adliechty/DaisySeedBreakout/BOM_Summary.csv

PCB Quantity | Mouser Component Cost | Mouser Missing Part Numbers | Digikey Component Cost | Digikey Missing Part Numbers | Cheapest Vendor Component Cost | Cheapest Vendor Missing Part Numbers
1 | 29.21 | 0 | 16.65 | 2 | 19.01 | 0
10 | 22.119999999999997 | 0 | 12.62 | 2 | 14.92 | 0
100 | 17.37 | 0 | 10.159999999999998 | 2 | 12.189999999999998 | 0
1000 | 12.69 | 0 | 8.909999999999998 | 2 | 10.34 | 0
