adliechty/DaisySeedBreakout/SymbolsAndFootprints/1x2Female/1x2Female.step

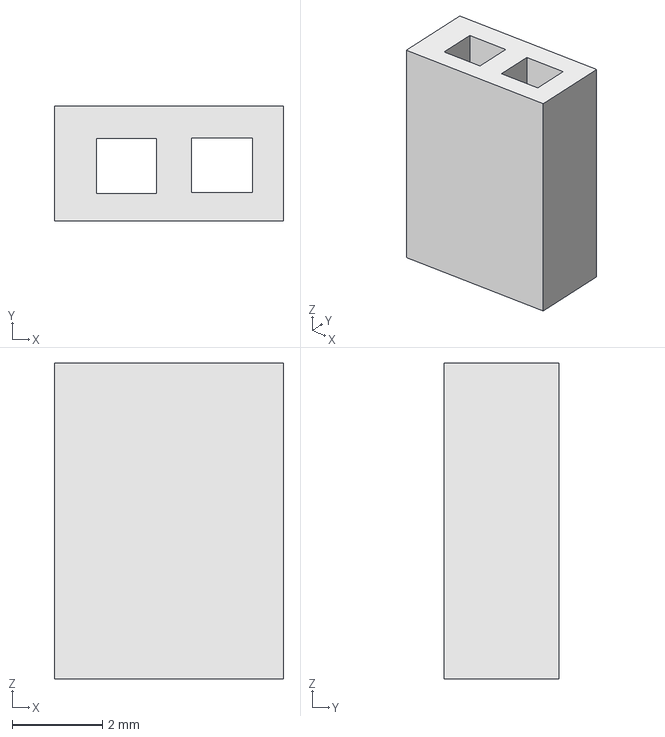
[picture p1: CAD file, 2023-09-30]
SymbolsAndFootprints/1x2Female/1x2Female.step
5.08 x 2.54 x 7.00 mm
