adliechty/DaisySeedBreakout/SymbolsAndFootprints/1x3Female/SSW-103-01-G-S.stp

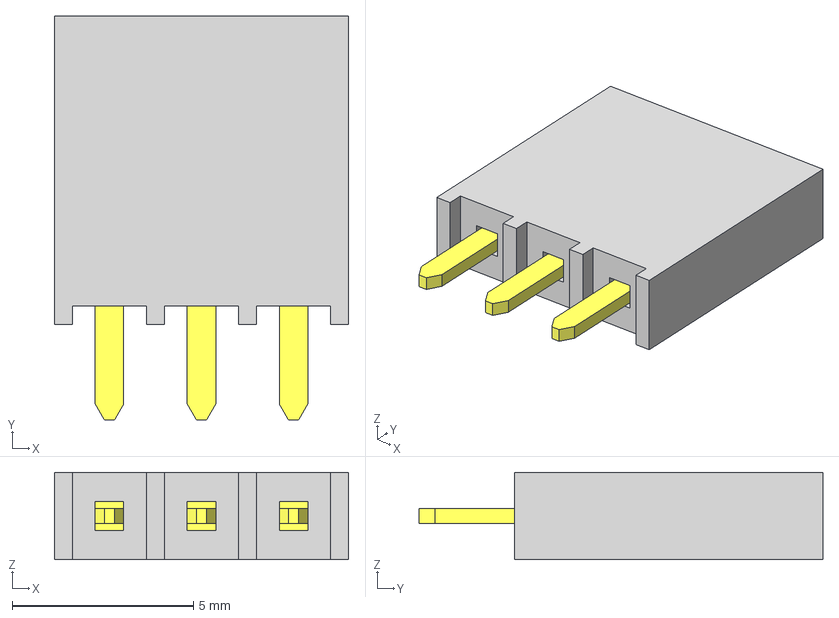
[picture p2: CAD file, 2023-09-27]
SymbolsAndFootprints/1x3Female/SSW-103-01-G-S.stp
8.13 x 11.2 x 2.41 mm
P2SSW-103-01-G-S
T1SSW-103-01-G-S
