adliechty/DaisySeedBreakout/SymbolsAndFootprints/1x6Female/1x6Female.step

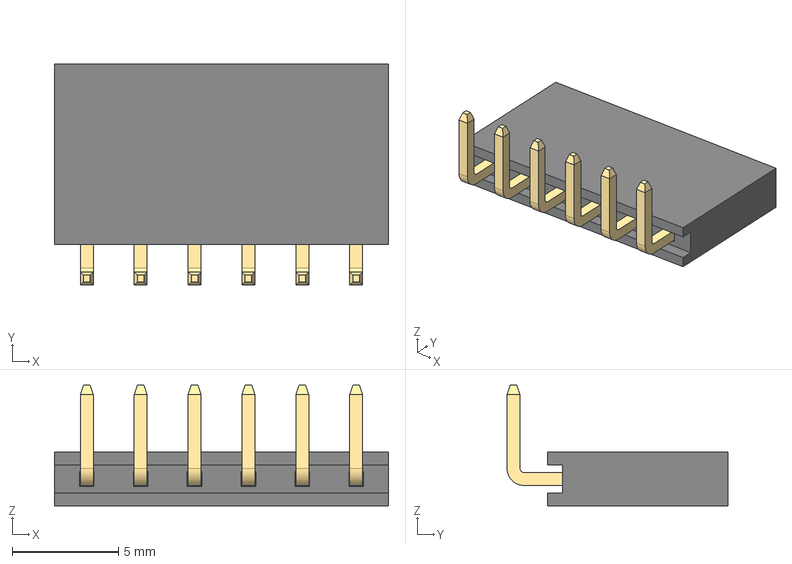
[picture p3: CAD file, 2023-09-27]
SymbolsAndFootprints/1x6Female/1x6Female.step
15.7 x 10.4 x 5.70 mm
