adliechty/DaisySeedBreakout/SymbolsAndFootprints/2x8Female/2x8Female.step

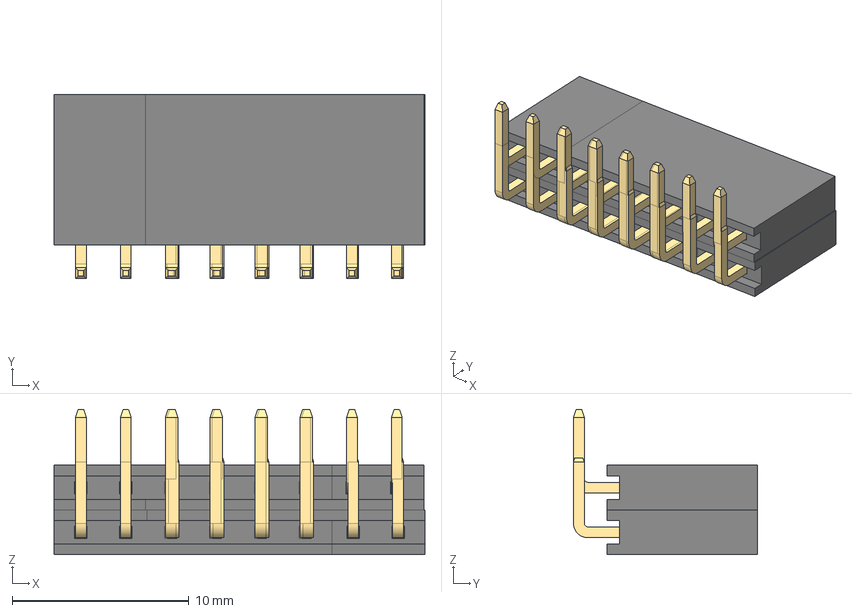
[picture p4: CAD file, 2023-09-27]
SymbolsAndFootprints/2x8Female/2x8Female.step
21.0 x 10.4 x 8.22 mm
1x6_RF
1x6_RF001
1x6_RF002
1x6_RF003
