adliechty/DaisySeedBreakout/SymbolsAndFootprints/Daisy Seed/DaisySeed-BodyPad003.step

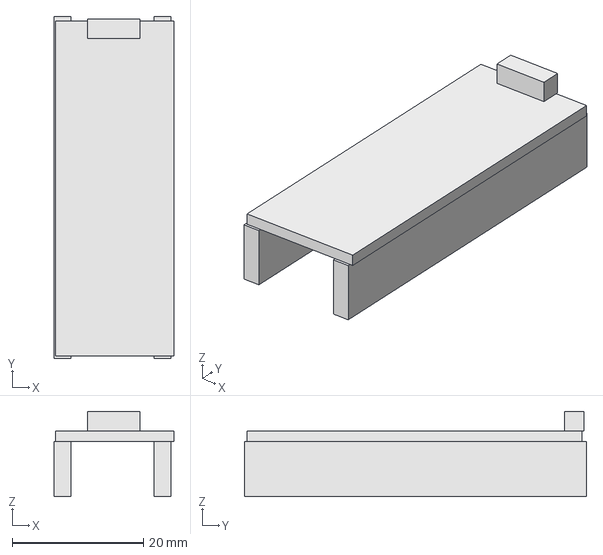
[picture p5: CAD file, 2023-09-25]
SymbolsAndFootprints/Daisy Seed/DaisySeed-BodyPad003.step
18.2 x 52.1 x 13.0 mm
