adliechty/DaisySeedBreakout/SymbolsAndFootprints/Microphone/Microphone.step

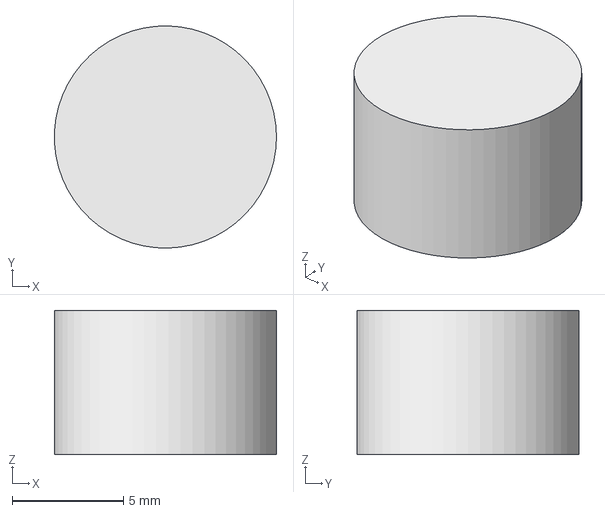
[picture p6: CAD file, 2023-09-25]
SymbolsAndFootprints/Microphone/Microphone.step
9.99 x 10.00 x 6.50 mm
