adliechty/DaisySeedBreakout/SymbolsAndFootprints/STX-4235-3-3-N/DaisySeed-BodyPad003.step

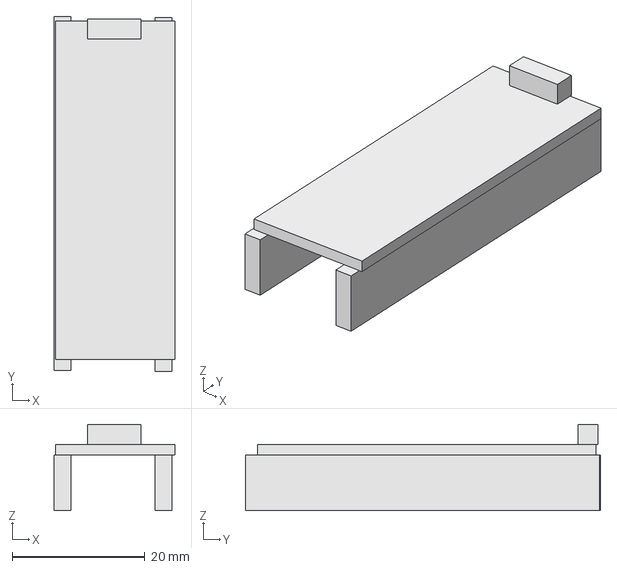
[picture p8: CAD file, 2023-09-25]
SymbolsAndFootprints/STX-4235-3-3-N/DaisySeed-BodyPad003.step
18.2 x 53.5 x 13.0 mm
