adliechty/DaisySeedBreakout/SymbolsAndFootprints/SurfaceMountAudio/surfaceMountAudio.step

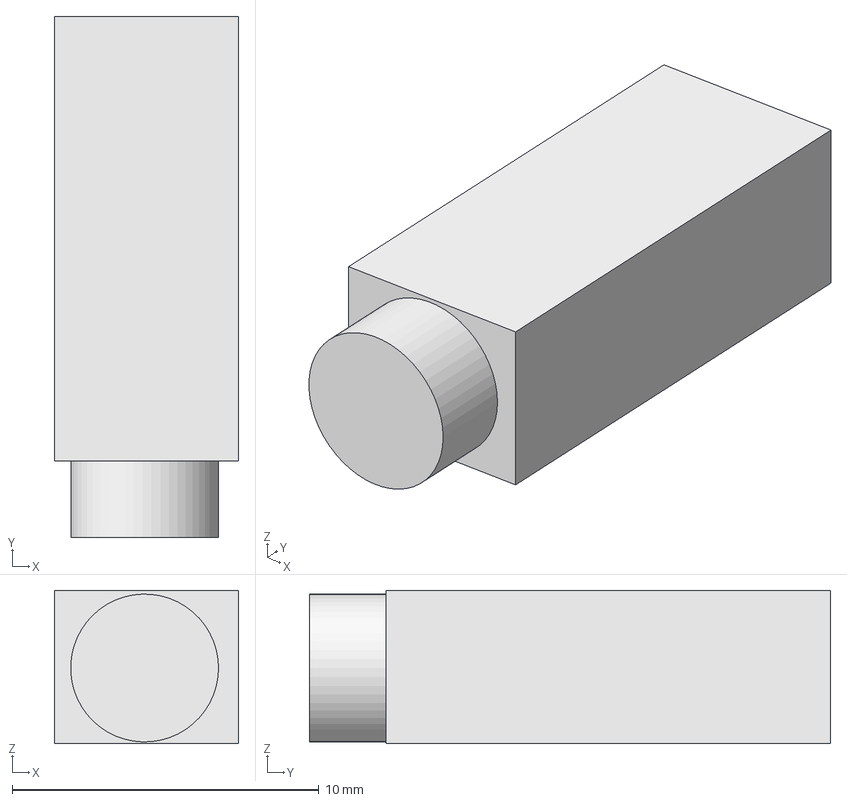
[picture p9: CAD file, 2023-09-26]
SymbolsAndFootprints/SurfaceMountAudio/surfaceMountAudio.step
6.00 x 17.0 x 5.00 mm
