adliechty/DaisySeedBreakout/SymbolsAndFootprints/STX-4235-3-3-N/Dual Audio-Body.step

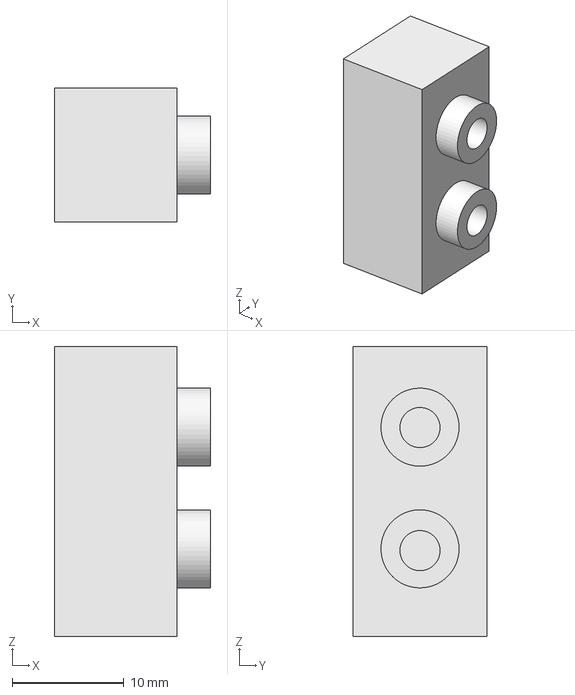
[picture p10: CAD file, 2023-09-25]
SymbolsAndFootprints/STX-4235-3-3-N/Dual Audio-Body.step
14.0 x 12.0 x 26.0 mm
