adliechty/DaisySeedBreakout/SymbolsAndFootprints/2x10FemaleHeader/87606-310LF.step

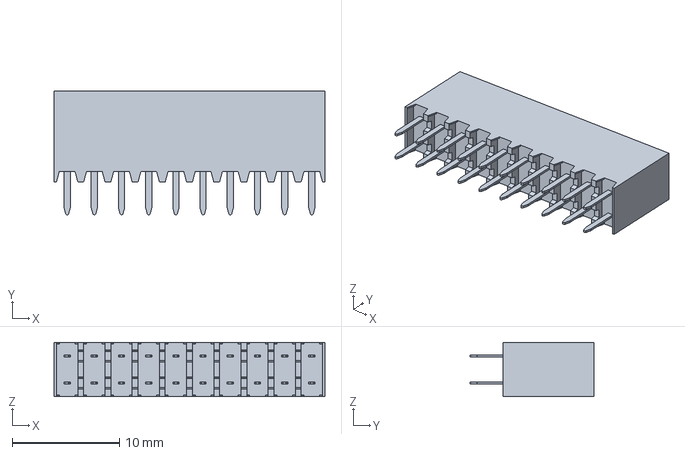
[picture p11: CAD file, 2023-10-08]
SymbolsAndFootprints/2x10FemaleHeader/87606-310LF.step
25.3 x 11.6 x 5.08 mm
