adliechty/DaisySeedBreakout/(list of files, cad)

Other CAD files:
SymbolsAndFootprints/Daisy Seed/DaisySeed-BodySketch003.step
SymbolsAndFootprints/Daisy Seed/DaisySeed.FCStd
SymbolsAndFootprints/STX-4235-3-3-N/Dual Audio.FCStd
SymbolsAndFootprints/Daisy Seed/Daisy Seed.f3d
SymbolsAndFootprints/Daisy Seed/Daisy Seed.iges
SymbolsAndFootprints/Daisy Seed/Daisy Seed.skp
SymbolsAndFootprints/Microphone/Microphone.FCStd
SymbolsAndFootprints/SurfaceMountAudio/surfaceMountAudio.FCStd
