adliechty/DaisySeedBreakout/DaisySeedBreakout.kicad_pcb

## KiCad design DaisySeedBreakout.kicad_pcb (2023-11-04)

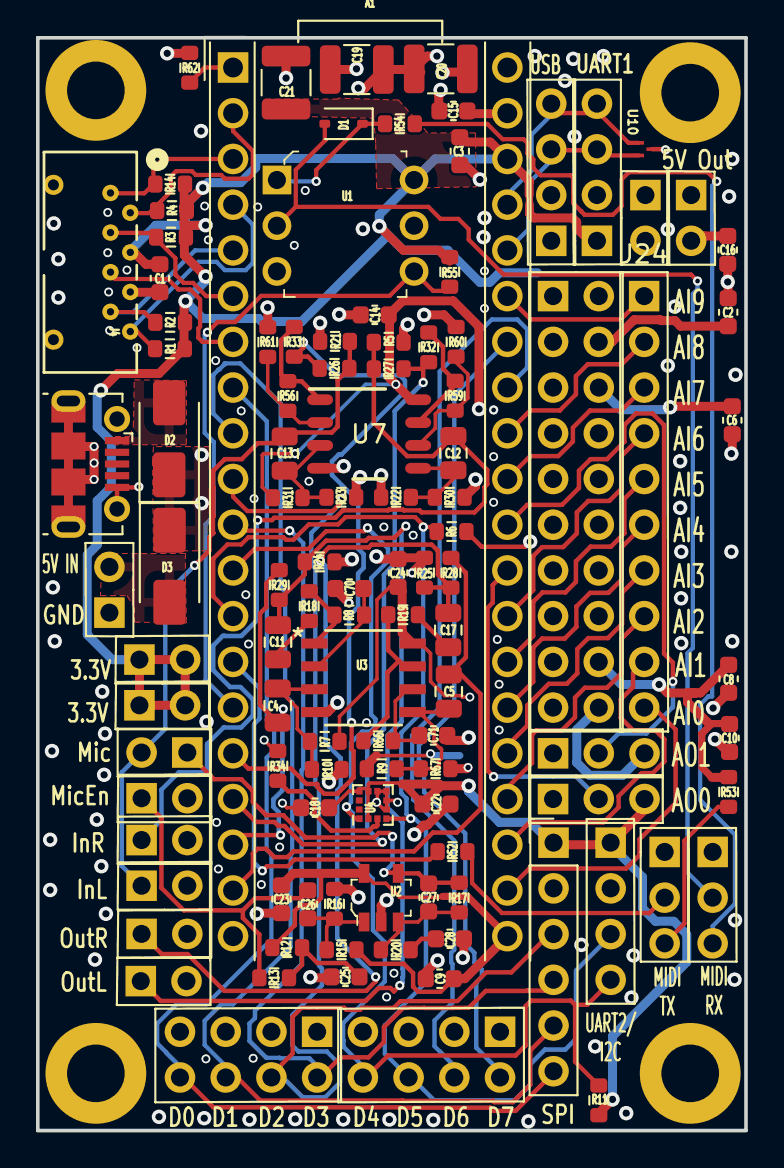
[picture p12: board DaisySeedBreakout.kicad_pcb from above]

Board: 4 copper layers, 39.3 x 60.7 mm, 113 parts (0 on the bottom side), 71 nets.

Parts:
A1: Electrosmith_Daisy_Seed_Rev4; Electrosmith_Daisy_Seed
C1, C2, C3, C6, C8, C9, C10, C14, C15, C16, C18, C22, C23, C24, C25, C26: 0.1uF 0402; C_0603_1608Metric
C4, C5, C11, C12, C13, C17: 10U; C_0805_2012Metric
C19: 100uF; C_1210_3225Metric
C20, C21: DNP_100uF; C_1210_3225Metric
C27: 100pF COG; C_0603_1608Metric
C28: 1uF; C_0603_1608Metric
C70, C71: DNP; C_0603_1608Metric
D1: D_Schottky; D_SOD-323
D2, D3: SS54; D_SMA
H1, H2, H3, H4: MountingHole; MountingHole_3.2mm_M3_DIN965_Pad
J1, J3, J10, J14: Conn_01x03; PinHeader_1x03_P2.54mm_Vertical_Female
J2, J6, J8, J9, J11, J12, J13, J16, J17, J25, J26: Conn_01x02; PinHeader_1x02_P2.54mm_VerticalFemale
J4: Micro_SD_Card; CONN_PJS008U-3000-0_YAM
J5, J7, J20: Conn_01x04; PinHeader_1x04_P2.54mm_Vertical_Female
J15: USB_B_Micro; USB_Micro-B_Molex-105017-0001
J18, J21: Conn_02x04; PinHeader_2x04_P2.54mm_Vertical_Female
J19: Conn_01x06; PinHeader_1x06_P2.54mm_Vertical_Female
J23: Pins_02x10_P2.54mm_TH; PinHeader_2x10_P2.54mm_Vertical
J24: Conn_01x10; PinHeader_1x10_P2.54mm_Vertical_Female
R1, R2, R3, R4, R14: 47k; R_0603_1608Metric
R5, R7, R9, R10, R15, R16, R21, R22, R23, R24, R25, R30, R31, R67: 1M; R_0603_1608Metric
R6, R11, R20: 10k; R_0603_1608Metric
R8, R56, R59, R62, R66: 0; R_0603_1608Metric
R12, R13: 2.2k; R_0603_1608Metric
R17: 100k; R_0603_1608Metric
R18, R19: 100; R_0603_1608Metric
R26, R27, R28, R29, R34, R60, R61: DNP; R_0603_1608Metric
R32, R33: 4.7k; R_0603_1608Metric
R52: 10; R_0603_1608Metric
R53: 33; R_0603_1608Metric
R54: 220; R_0603_1608Metric
R55: 470; R_0603_1608Metric
U1: H11L1M; DIP-6_W7.62mm
U2: MAX4466EXK_T; SOT-353
U3: D8_TEX
U4: LIS2DE12; LGA-12_2x2mm_P0.5mm
U7: TLV9062IDR; D0008A_N
U10: TPD2EUSB30ADRTR; DRT3

Connections:
+3.3V: A1.38 (3V3_D), C1.1, C2.1, C3.1, C6.1, C8.1, C10.1, C18.1, C21.1, C22.1, J4.4 (VDD), J7.1, J10.3, J14.3, J19.1, J20.1, J23.2, J23.4, J23.6, J23.8, J23.10, J23.12, J23.14, J23.16, J23.18, J23.20, J25.1, J25.2, J26.1, J26.2, R1.1, R2.1, R3.1, R4.1, R6.1, R11.1, R14.1, R53.1, R55.2, U1.6 (VCC), U4.2 (~CS), U4.9 (Vdd), U4.10 (Vdd_IO)
+3.3VA: A1.21 (3V3_A), C9.1, C14.1, C23.1, C24.1, R7.1, R9.1, R12.2, R15.2, R30.1, R31.1, U2.5 (VCC), U3.8 (V+), U7.8 (V+)
+5V: A1.39 (VIN), C15.1, C16.1, C19.1, C20.1, D2.1 (K), D3.1 (K), J5.1, J9.1, J9.2, J16.1, J16.2
/AI_0: A1.22 (ADC_0), J24.10
/AI_1: A1.23 (ADC_1), J24.9
/AI_2: A1.24 (ADC_2), J24.8
/AI_3: A1.25 (ADC_3), J24.7
/AI_4: A1.26 (ADC_4), J24.6
/AI_5: A1.27 (ADC_5), J24.5
/AI_6: A1.28 (ADC_6), J24.4
/AI_7: A1.31 (SAI2_MCLK), J24.3
/AI_8: A1.32 (SAI2_SD_B), J24.2
/AI_9: A1.35 (SAI2_SCK), J24.1
/AO_0: A1.29 (DAC_OUT2), J10.2
/AO_1: A1.30 (DAC_OUT1), J14.2
/Audio In/L_in+: C13.2, R23.1, R31.2, U7.3 (IN+)
/Audio In/L_in-: R56.2, R61.1, U7.2 (IN-)
/Audio In/L_out+: R33.2, R56.1, U7.1 (OUT)
/Audio In/R_in+: C12.2, R22.1, R30.2, U7.5 (IN+)
/Audio In/R_in-: R59.2, R60.1, U7.6 (IN-)
/Audio In/R_out+: R32.2, R59.1, U7.7 (OUT)
/Audio Out/L_in+: C4.2, R7.2, R10.1, U3.3 (+IN_A)
/Audio Out/L_in-: C70.1, R8.1, U3.2 (-A)
/Audio Out/L_out: R8.2, R18.1, U3.1
/Audio Out/R_in+: C5.2, R9.2, R67.1, U3.5 (+IN_B)
/Audio Out/R_in-: C71.1, R66.1, U3.6 (-B)
/Audio Out/R_out: R19.1, R66.2, U3.7
/Audio_IN_1: A1.16 (AUDIO_IN_1), R26.1, R33.1
/Audio_IN_2: A1.17 (AUDIO_IN_2), R27.1, R32.1
/Audio_IN_L_CONN: C13.1, J8.2, J12.1, R21.1, R26.2
/Audio_IN_R_CONN: C12.1, J13.1, R5.1, R27.2
/Audio_OUT_1: A1.18 (AUDIO_OUT_1), C4.1, R29.2
/Audio_OUT_2: A1.19 (AUDIO_OUT_2), C5.1, R28.2
/Audio_OUT_L_CONN: C11.2, J2.1, R24.1, R29.1
/Audio_OUT_R_CONN: C17.2, J11.1, R25.1, R28.1
/Condensor Microphone/MIC_BIAS: C25.1, R12.1, R13.2
/Condensor Microphone/MIC_CONN: C26.1, J17.1, R13.1
/Condensor Microphone/MIC_IN+: C26.2, R15.1, R16.2, U2.1
/Condensor Microphone/MIC_IN-: C27.1, R17.2, R20.2, U2.3
/DIO0_CS: A1.8 (SPI1_CS), J19.6, J21.8
/DIO1_SCK: A1.9 (SPI1_SCK), J19.5, J21.6
/DIO2_POCI: A1.10 (SPI1_POCI), J19.3, J21.4
/DIO3_PICO: A1.11 (SPI1_PICO), J19.4, J21.2
/DIO4_SCL_RX: A1.12 (I2C1_SCL), J7.4, J18.8, R11.2, U4.1 (SCL/SPC)
/DIO5_SDA_TX: A1.13 (I2C1_SDA), J7.3, J18.6, R6.2, U4.4 (SDA/SDI)
/DIO6: A1.33 (SAI2_SD_A), J18.4
/DIO7: A1.34 (SAI2_FS), J18.2
/HEADER_5V: D3.2 (A), J6.2
/MIDI_IN_CONN: D1.2 (A), J3.2, U1.2
/MIDI_IN_CONN_R: J3.3, R54.2
/MIDI_IN_Diode: D1.1 (K), R54.1, U1.1
/MIDI_TX_CONN: J1.2, R52.2
/MIDI_TX_PWR: J1.3, R53.2
/MIDI_UART_RX: A1.15 (USART1_RX), R55.1, U1.4 (VO)
/MIDI_UART_TX: A1.14 (USART1_TX), R52.1
/Mic_OUT: C27.2, J8.1, R17.1, U2.4
/SD_CLK: A1.7 (SD_CLK), J4.5 (CLK)
/SD_CMD: A1.6 (SD_CMD), J4.3 (CMD), R3.2
/SD_D0: A1.5 (SD_DATA_0), J4.7 (DAT0), R2.2
/SD_D1: A1.4 (SD_DATA_1), J4.8 (DAT1), R1.2
/SD_D2: A1.3 (SD_DATA_2), J4.1 (DAT2), R14.2
/SD_D3: A1.2 (SD_DATA_3), J4.2 (DAT3/CD), R4.2
/USB_5V: D2.2 (A), J15.1 (VBUS)
/USB_n: A1.36 (USB_D_-), J5.3, J20.3, U10.2 (D-)
/USB_p: A1.37 (USB_D_+), J5.4, J20.4, U10.1 (D+)
GND: A1.20 (AGND), A1.40 (DGND), C1.2, C2.2, C3.2, C6.2, C8.2, C9.2, C10.2, C14.2, C15.2, C16.2, C18.2, C19.2, C20.2, C21.2, C22.2, C23.2, C24.2, C25.2, C28.1, C70.2, C71.2, H1.1, H2.1, H3.1, H4.1, J1.1, J2.2, J3.1, J4.6 (VSS), J5.2, J6.1, J7.2, J10.1, J11.2, J12.2, J13.2, J14.1, J15.5 (GND), J15.6 (Shield), J17.2, J18.1, J18.3, J18.5, J18.7, J19.2, J20.2, J21.1, J21.3, J21.5, J21.7, J23.1, J23.3, J23.5, J23.7, J23.9, J23.11, J23.13, J23.15, J23.17, J23.19, R5.2, R10.2, R16.1, R21.2, R22.2, R23.2, R24.2, R25.2, R34.1, R60.2, R61.2, R62.2, R67.2, U1.5 (GND), U2.2 (GND), U3.4 (V-), U4.5 (RES), U4.6 (GND), U4.7 (GND), U4.8 (GND), U7.4 (V-), U10.3 (GND)
unnamed: A1.1 (USB_ID), R62.1
unnamed: C11.1, R18.2
unnamed: C17.1, R19.2
unnamed: C28.2, R20.1
unnamed: R34.2, U4.3 (SA0/SDO)
