adliechty/DaisySeedBreakout/(commit log)

2023-09-22 First addition
    [Audio Out.kicad_sch, AudioInSum.kicad_sch, Condensor Microphone.kicad_sch, DaisySeedBreakout.kicad_pcb, DaisySeedBreakout.kicad_sch, I2C 24 GPIO.kicad_sch, microSD.kicad_sch]
2023-09-23 Fixed ultralibrarian library with capital letter difference
    [Audio Out.kicad_sch, AudioInSum.kicad_sch, DaisySeedBreakout.kicad_pcb, DaisySeedBreakout.kicad_sch]
2023-09-23 added knob headers, MIDI in header
    [Audio Out.kicad_sch, DaisySeedBreakout.kicad_pcb, DaisySeedBreakout.kicad_sch]
2023-09-24 added double high audio jack
    [DaisySeedBreakout.kicad_pcb, DaisySeedBreakout.kicad_sch]
2023-09-25 adding 3d models
    [Daisy Seed.f3d, Daisy Seed.iges, Daisy Seed.skp, DaisySeed-BodyPad003.step, DaisySeed-BodySketch003.step, DaisySeed.FCStd, DaisySeedBreakout.kicad_pcb, DaisySeedBreakout.kicad_sch]
2023-09-26 adding mono connectors, CV, and gate as well
    [AudioInSum.kicad_sch, DaisySeedBreakout.kicad_pcb, DaisySeedBreakout.kicad_sch, Microphone.FCStd, surfaceMountAudio.FCStd, surfaceMountAudio.step]
2023-09-27 update design to use more headers. Need to figure out easy way to integrate connectors in modular but easy to use way without dangling wires
    [1x6Female.step, 2x8Female.step, DaisySeedBreakout.kicad_pcb, DaisySeedBreakout.kicad_sch, SSW-103-01-G-S.stp]
2023-09-28 added dual audio back in to prototype that concept
    [1x2Female.step, DaisySeedBreakout.kicad_pcb, DaisySeedBreakout.kicad_sch]
2023-09-30 Converted circuits to sub circuits. Removed MIDI connector, changed to header only
    [1x2Female.step, AI_GPIO.kicad_sch, Analog_out_conn.kicad_sch, DaisySeedBreakout.kicad_pcb, DaisySeedBreakout.kicad_sch, GPIO_Conn.kicad_sch, MIDI_IN.kicad_sch, MIDI_OUT.kicad_sch]
2023-09-30 Minor modifications
    [AI_GPIO.kicad_sch, Analog_out_conn.kicad_sch, DaisySeedBreakout.kicad_sch, GPIO_Conn.kicad_sch, MIDI_IN.kicad_sch, MIDI_OUT.kicad_sch, arduino_coprocessor.kicad_sch]
2023-10-01 Placeholder for speaker driver
    [Audio Out.kicad_sch, DaisySeedBreakout.kicad_pcb, DaisySeedBreakout.kicad_sch, arduino_coprocessor.kicad_sch]
2023-10-02 add input fuse holder, TVS, reverse diode protection, placeholder 5V LDO
    [Analog_out_conn.kicad_sch, ClassD_20W_Amp.kicad_sch, DaisySeedBreakout.kicad_pcb, DaisySeedBreakout.kicad_sch, GPIO_Conn.kicad_sch]
2023-10-02 add usb host current limit and ESD diodes
    [ClassD_20W_Amp.kicad_sch, DaisySeedBreakout.kicad_pcb, DaisySeedBreakout.kicad_sch]
2023-10-05 Add USB 5V switcher, adjust audio in circuit
    [Audio Out.kicad_sch, AudioInSum.kicad_sch, DaisySeedBreakout.kicad_pcb, DaisySeedBreakout.kicad_sch]
2023-10-06 Update Audio out to switch between 1V ptp or 10V ptp based on jumper
    [Audio Out.kicad_sch, AudioInSum.kicad_sch, DaisySeedBreakout.kicad_pcb, DaisySeedBreakout.kicad_sch]
2023-10-07 getting closer
    [3p3V_AI_to_CV.kicad_sch, 3p3V_AO_to_CV.kicad_sch, 5V_Power.kicad_sch, Audio Out.kicad_sch, AudioInSum.kicad_sch, CV_to_3p3V_AI.kicad_sch, ClassD_20W_Amp.kicad_sch, Condensor Microphone.kicad_sch]
2023-10-08 trying grid of female headers to reduce header count and enable plug in modules
    [87606-310LF.step, DaisySeedBreakout.kicad_sch]
2023-10-09 commit before simplifyting the board further
    [5V_Power.kicad_sch, ArduinoCompanion.kicad_sch, CV_to_3p3V_AI.kicad_sch, DaisySeedAccessories.kicad_sch, EurRackToLine.kicad_sch, SpeakerDriver20W.kicad_sch]
2023-10-09 simplified design, rely on external boards more to cover those cases
    [5V_Power.kicad_sch, ArduinoCompanion.kicad_sch, CV_to_3p3V_AI.kicad_sch, DaisySeedAccessories.kicad_sch, DaisySeedBreakout.kicad_pcb, DaisySeedBreakout.kicad_sch, EurRackToLine.kicad_sch, MIDI_IN.kicad_sch]
2023-10-10 started layout
    [AudioInSum.kicad_sch, DaisySeedBreakout.kicad_pcb, DaisySeedBreakout.kicad_sch, MIDI_IN.kicad_sch]
2023-10-11 partially routed
    [Condensor Microphone.kicad_sch, DaisySeedBreakout.kicad_pcb]
2023-10-15 periodic update
    [12V_To_5V.kicad_sch, 5V_Power.kicad_sch, ArduinoCompanion.kicad_sch, AudioInSum.kicad_sch, CV_to_3p3V_AI.kicad_sch, Condensor Microphone.kicad_sch, DaisySeedAccessories.kicad_sch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]
2023-10-16 added dedicated SPI, UART, I2C connectors
    [Audio Out.kicad_sch, AudioInSum.kicad_sch, DaisySeedBreakout.kicad_pcb, DaisySeedBreakout.kicad_sch]
2023-10-19 further connector exploration
2023-10-20 Layout routed, no DRC yet
    [Condensor Microphone.kicad_sch, DaisySeedBreakout.kicad_pcb, DaisySeedBreakout.kicad_sch, MIDI_IN.kicad_sch, MIDI_OUT.kicad_sch]
2023-10-21 PCB cleanup, added accelerometer as easy sensor to begin with
    [Audio Out.kicad_sch, AudioInSum.kicad_sch, Condensor Microphone.kicad_sch, DaisySeedBreakout.kicad_pcb, DaisySeedBreakout.kicad_sch, MIDI_IN.kicad_sch, MIDI_OUT.kicad_sch]
2023-10-22 some cleanup
    [Audio Out.kicad_sch, AudioInSum.kicad_sch, Condensor Microphone.kicad_sch, DaisySeedBreakout.csv, DaisySeedBreakout.kicad_pcb, DaisySeedBreakout.kicad_sch, microSD.kicad_sch]
2023-10-23 updated parts with those available on jlpcb
    [Audio Out.kicad_sch, AudioInSum.kicad_sch, Condensor Microphone.kicad_sch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]
2023-10-24 some PCB cleanup
    [JLPCB_BOM.csv, JLPCB_Part_Numbers.csv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]
2023-10-25 moving to through hole microSD connector vertical, and through hole daisy seed to cost optimize. Surface mount daisy seed headers seemed more expensive
    [DaisySeedBreakout.kicad_pcb, DaisySeedBreakout.kicad_sch, microSD.kicad_sch]
2023-10-26 Moved everything to the top side
    [Audio Out.kicad_sch, AudioInSum.kicad_sch, Condensor Microphone.kicad_sch, DaisySeedBreakout.kicad_pcb, DaisySeedBreakout.kicad_sch, microSD.kicad_sch]
2023-10-27 periodic commit
    [DaisySeedBreakout.kicad_pcb]
2023-10-27 Minor updates
    [DaisySeedBreakout.kicad_pcb, JLPCB_Part_Numbers.csv]
2023-10-29 making way to generate digikey and mouser boms...work in progress
    [DaisySeedBreakout-B_Cu.gbr, DaisySeedBreakout-B_Mask.gbr, DaisySeedBreakout-B_Paste.gbr, DaisySeedBreakout-B_Silkscreen.gbr, DaisySeedBreakout-Edge_Cuts.gbr, DaisySeedBreakout-F_Cu.gbr, DaisySeedBreakout-F_Mask.gbr, DaisySeedBreakout-F_Paste.gbr]
2023-10-30 adding script to pull prices and availability from Mouser
    [Audio Out.kicad_sch, AudioInSum.kicad_sch, Condensor Microphone.kicad_sch, DaisySeedBreakout.csv, DaisySeedBreakout.kicad_sch, PartNumbers.csv, microSD.kicad_sch]
2023-10-31 Mouser BOM rollup working
    [BOM_Summary.csv, DaisySeedBreakout.csv, PartNumbers.csv]
2023-11-02 digikey API for BOM seems to be working
    [BOM_Summary.csv, DaisySeedBreakout.csv, PartNumbers.csv]
2023-11-03 Exporting of Mouser, Digikey, and JLPCB BOMs seems to be working
    [BOM_Summary.csv, DaisySeedBreakout.csv, Digikey_Part_List.csv, JLPCB_Part_List.csv, Mouser_Part_List.csv, PartNumbers.csv]
2023-11-04 script working to generate Mouser, Digikey, and JLPCB BOMS
    [Audio Out.kicad_sch, AudioInSum.kicad_sch, Condensor Microphone.kicad_sch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]
2023-11-05 minor cleanup
    [DaisySeedBreakout.kicad_pcb, DaisySeedBreakout.kicad_sch]
2023-11-10 PCB submitted for order
    [12V_To_5V.kicad_sch, 3p3V_AI_to_CV.kicad_sch, 3p3V_AO_to_CV.kicad_sch, 5V_Power.kicad_sch, ArduinoCompanion.kicad_sch, CV_to_3p3V_AI.kicad_sch, DaisySeedAccessories.kicad_pcb, DaisySeedAccessories.kicad_sch]
