adliechty/DaisySeedBreakout/(notices)

Notices in the files:
SymbolsAndFootprints/1x3Female/SSW-103-01-G-S.stp:
author */ ('License CC BY-ND 4.0'),
parts and their libraries:
Copyright 2016 Accelerated Designs. All rights reserved.
